AtomSoftTech/NeuWatch/presolder_01.jpg

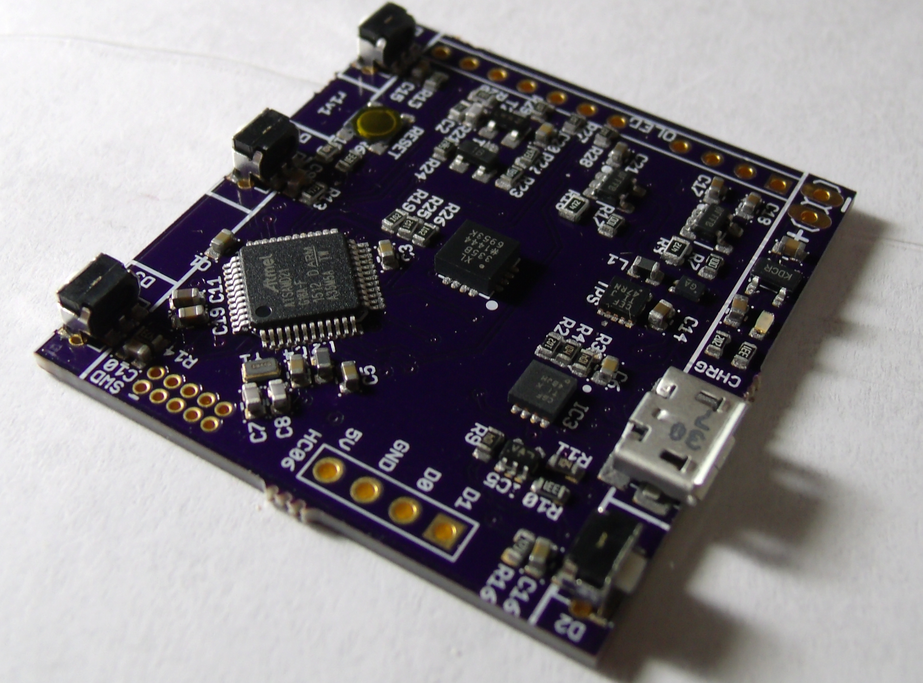
presolder_01.jpg
