AtomSoftTech/NeuWatch/soldered_02.jpg

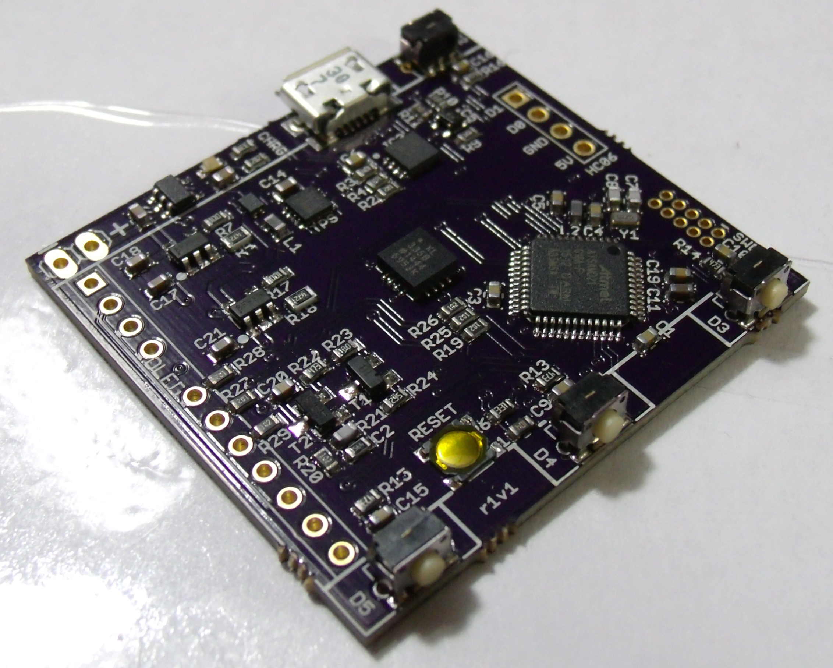
soldered_02.jpg
