AtomSoftTech/NeuWatch/readme.md

An ArduinoZero compatible watch with extra Features:<br>
<br>
ADXL335 Accelerometer<br>
MCP73831 - Lipo Charger<br>
Custom battery sense circuit<br>
Oled and MicroSD stack on PCB <br>
HC06 Bluetooth<br>
Cool side buttons<br>
<br>
Will be programable via Arduino IDE as the Zero (native)
