AtomSoftTech/NeuWatch/NeuWatch.jpg

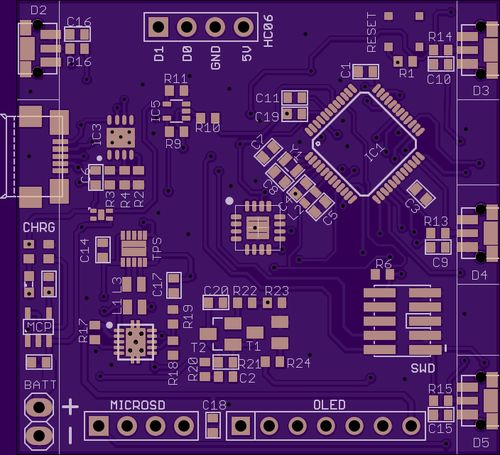
NeuWatch.jpg
