AtomSoftTech/NeuWatch/placement_chart.jpg

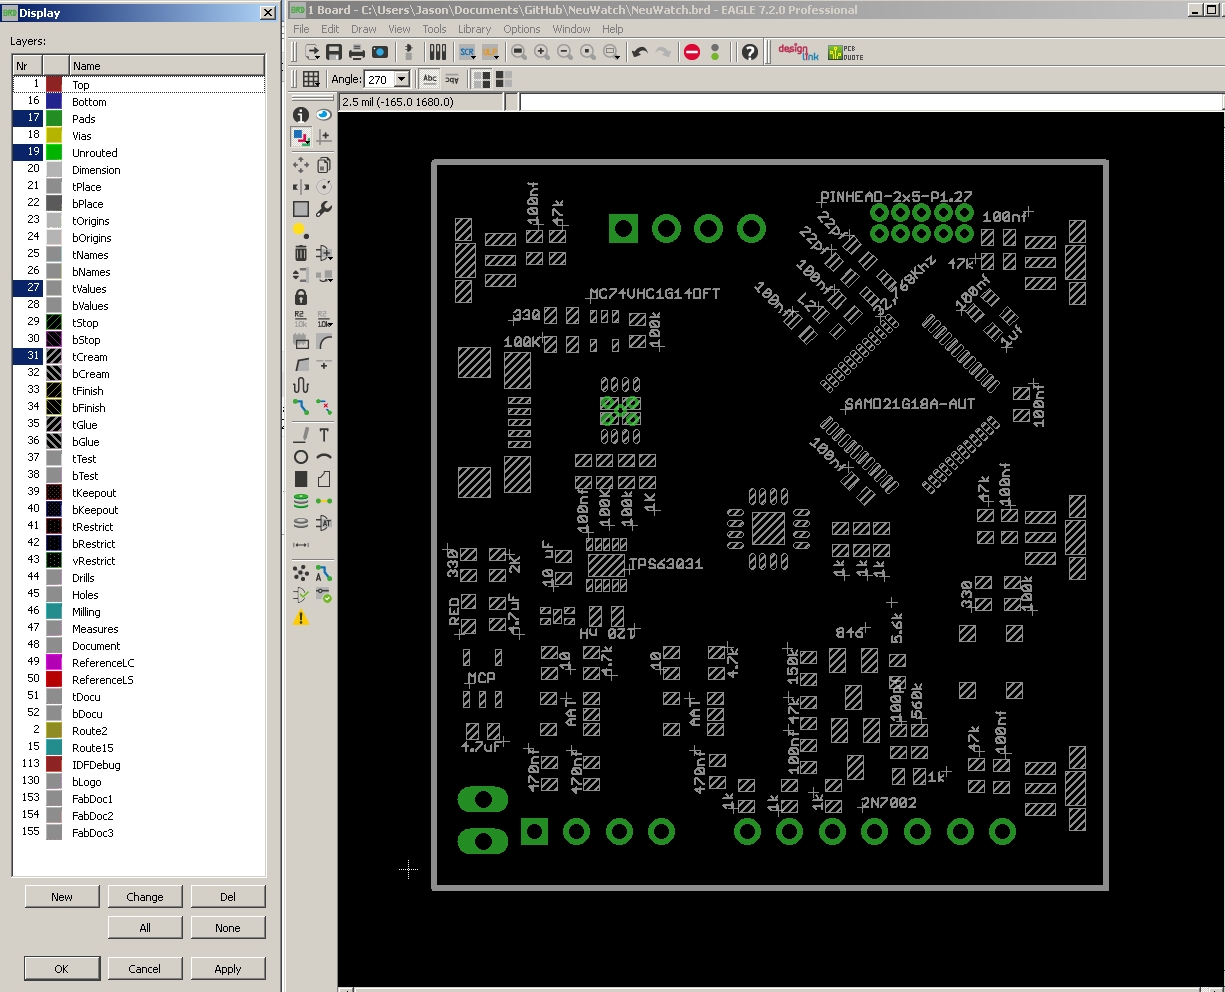
placement_chart.jpg
