AtomSoftTech/NeuWatch/NeuWatch.brd

## EAGLE design NeuWatch.brd (2015-08-29)

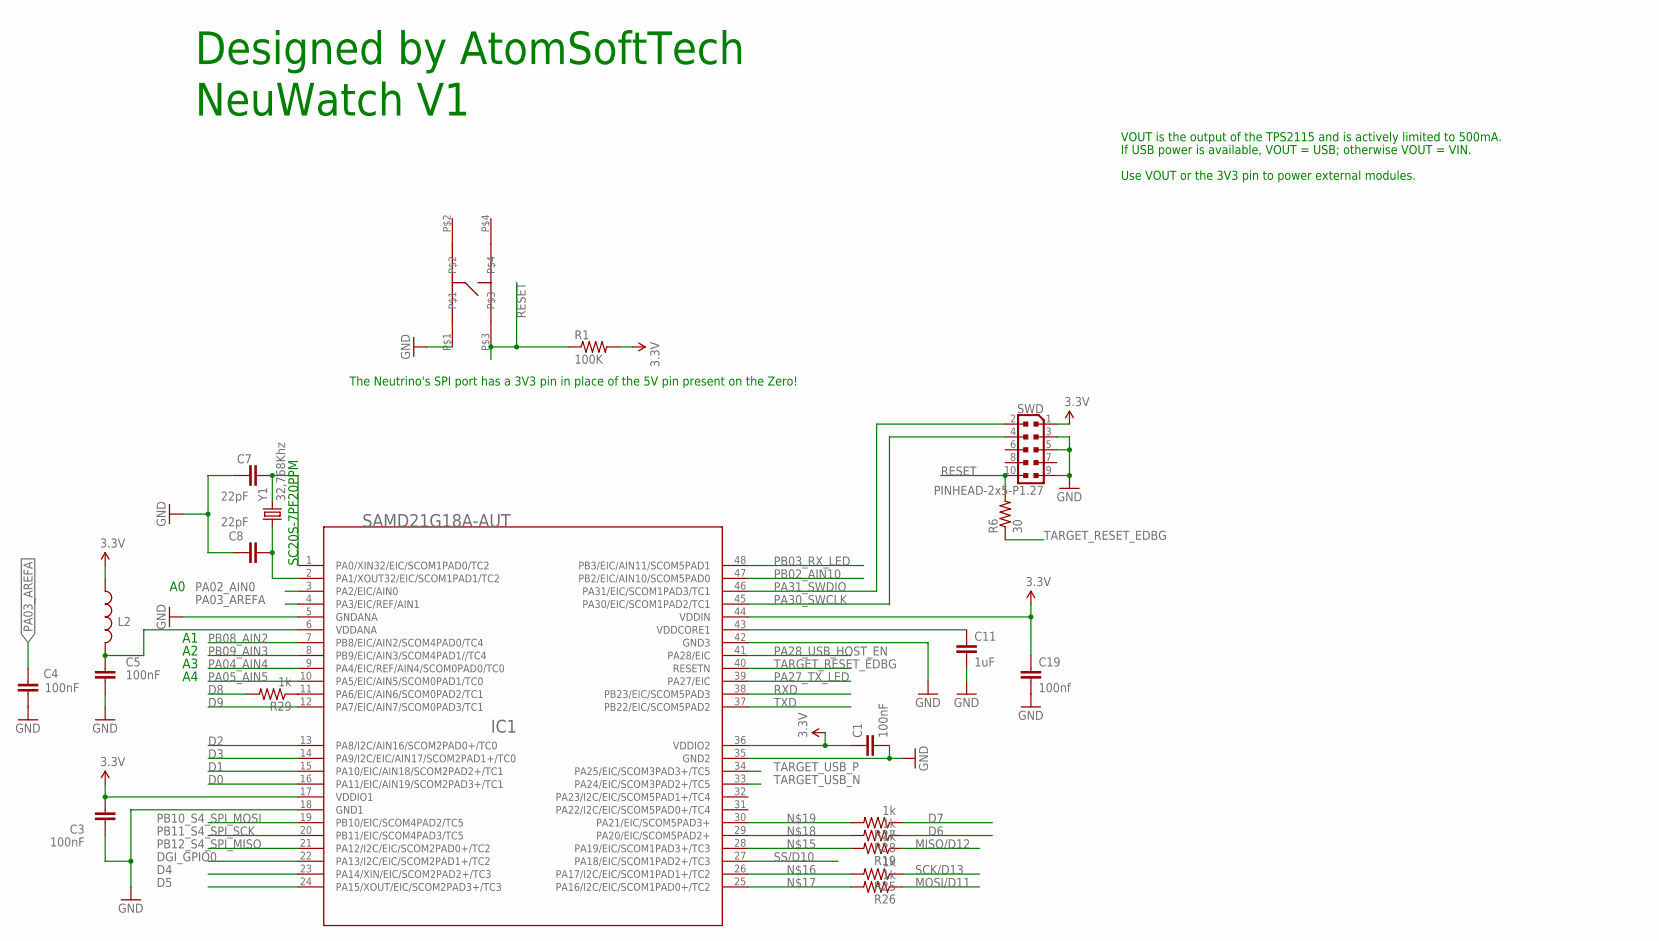
[picture p5: schematic NeuWatch.sch, sheet 1]

Parts:
C1, C3, C4, C5: 100nF; C0402
C7, C8: 22pF; C0402
C11: 1uF; C0402
C19: 100nf; C0402
IC1: SAMD21G18A-AUT; INTEGRATEDCIRCUITS_TQFP48-7X7
L2: INDUCTOR0603-TDK; 0603-TDK
R1: 100K; R0402
R6: 30; R0402
R19, R25, R26, R27, R28, R29: 1k; R0402
RESET: TACTILE_SWITCH; PTS540
SWD: PINHEAD-2x5-P1.27; ARDUINO-NEUTRINO-082_CONNETTORI_PINHEAD-2X5-P127
Y1: 32,768Khz; CRYSTAL-SMD-2.0X1.2

Connections:
3.3V: C1.1, C3.2, C19.1, IC1.17 (VDDIO1), IC1.36 (VDDIO2), IC1.44 (VDDIN), L2.1, R1.2, SWD.1; also elsewhere on the board
D0: IC1.16 (PA11/EIC/AIN19/SCOM2PAD3+/TC1); also elsewhere on the board
D1: IC1.15 (PA10/EIC/AIN18/SCOM2PAD2+/TC1); also elsewhere on the board
D2: IC1.13 (PA8/I2C/AIN16/SCOM2PAD0+/TC0); also elsewhere on the board
D3: IC1.14 (PA9/I2C/EIC/AIN17/SCOM2PAD1+/TC0); also elsewhere on the board
D4: IC1.23 (PA14/XIN/EIC/SCOM2PAD2+/TC3); also elsewhere on the board
D5: IC1.24 (PA15/XOUT/EIC/SCOM2PAD3+/TC3); also elsewhere on the board
D6: R28.1; also elsewhere on the board
D7: R27.1; also elsewhere on the board
D8: R29.2; also elsewhere on the board
D9: IC1.12 (PA7/EIC/AIN7/SCOM0PAD3/TC1); also elsewhere on the board
DGI_GPIO0: IC1.22 (PA13/I2C/EIC/SCOM2PAD1+/TC2)
GND: C1.2, C3.1, C4.2, C5.2, C7.1, C8.1, C11.2, C19.2, IC1.5 (GNDANA), IC1.18 (GND1), IC1.35 (GND2), IC1.42 (GND3), RESET.P$1, SWD.3, SWD.5, SWD.9; also elsewhere on the board
MISO/D12: R19.1; also elsewhere on the board
MOSI/D11: R26.1; also elsewhere on the board
unnamed: IC1.28 (PA19/EIC/SCOM1PAD3+/TC3), R19.2
unnamed: IC1.26 (PA17/I2C/EIC/SCOM1PAD1+/TC2), R25.2
unnamed: IC1.25 (PA16/I2C/EIC/SCOM1PAD0+/TC2), R26.2
unnamed: IC1.29 (PA20/EIC/SCOM5PAD2+), R28.2
unnamed: IC1.30 (PA21/EIC/SCOM5PAD3+), R27.2
unnamed: IC1.11 (PA6/EIC/AIN6/SCOM0PAD2/TC1), R29.1
PA00_XIN32: C7.2, IC1.1 (PA0/XIN32/EIC/SCOM1PAD0/TC2), Y1.2
PA01_XOUT32: C8.2, IC1.2 (PA1/XOUT32/EIC/SCOM1PAD1/TC2), Y1.1
PA02_AIN0: IC1.3 (PA2/EIC/AIN0); also elsewhere on the board
PA03_AREFA: C4.1, IC1.4 (PA3/EIC/REF/AIN1)
PA04_AIN4: IC1.9 (PA4/EIC/REF/AIN4/SCOM0PAD0/TC0); also elsewhere on the board
PA05_AIN5: IC1.10 (PA5/EIC/AIN5/SCOM0PAD1/TC0); also elsewhere on the board
PA27_TX_LED: IC1.39 (PA27/EIC)
PA28_USB_HOST_EN: IC1.41 (PA28/EIC); also elsewhere on the board
PA30_SWCLK: IC1.45 (PA30/EIC/SCOM1PAD2/TC1), SWD.4
PA31_SWDIO: IC1.46 (PA31/EIC/SCOM1PAD3/TC1), SWD.2
PB02_AIN10: IC1.47 (PB2/EIC/AIN10/SCOM5PAD0); also elsewhere on the board
PB03_RX_LED: IC1.48 (PB3/EIC/AIN11/SCOM5PAD1)
PB08_AIN2: IC1.7 (PB8/EIC/AIN2/SCOM4PAD0/TC4); also elsewhere on the board
PB09_AIN3: IC1.8 (PB9/EIC/AIN3/SCOM4PAD1//TC4); also elsewhere on the board
PB10_S4_SPI_MOSI: IC1.19 (PB10/EIC/SCOM4PAD2/TC5)
PB11_S4_SPI_SCK: IC1.20 (PB11/EIC/SCOM4PAD3/TC5)
PB12_S4_SPI_MISO: IC1.21 (PA12/I2C/EIC/SCOM2PAD0+/TC2)
RESET: R1.1, R6.2, RESET.P$3, SWD.10
RXD: IC1.38 (PB23/EIC/SCOM5PAD3)
SCK/D13: R25.1; also elsewhere on the board
SS/D10: IC1.27 (PA18/EIC/SCOM1PAD2+/TC3); also elsewhere on the board
TARGET_RESET_EDBG: IC1.40 (RESETN), R6.1
TARGET_USB_N: IC1.33 (PA24/EIC/SCOM3PAD2+/TC5); also elsewhere on the board
TARGET_USB_P: IC1.34 (PA25/EIC/SCOM3PAD3+/TC5); also elsewhere on the board
TXD: IC1.37 (PB22/EIC/SCOM5PAD2)
VDDANA: C5.1, IC1.6 (VDDANA), L2.2
VDDCORE: C11.1, IC1.43 (VDDCORE1)

Notes on the sheet:
The Neutrino's SPI port has a 3V3 pin in place of the 5V pin present on the Zero!
VOUT is the output of the TPS2115 and is actively limited to 500mA.
If USB power is available, VOUT = USB; otherwise VOUT = VIN.
Use VOUT or the 3V3 pin to power external modules.
Designed by AtomSoftTech
NeuWatch V1
SC20S-7PF20PPM

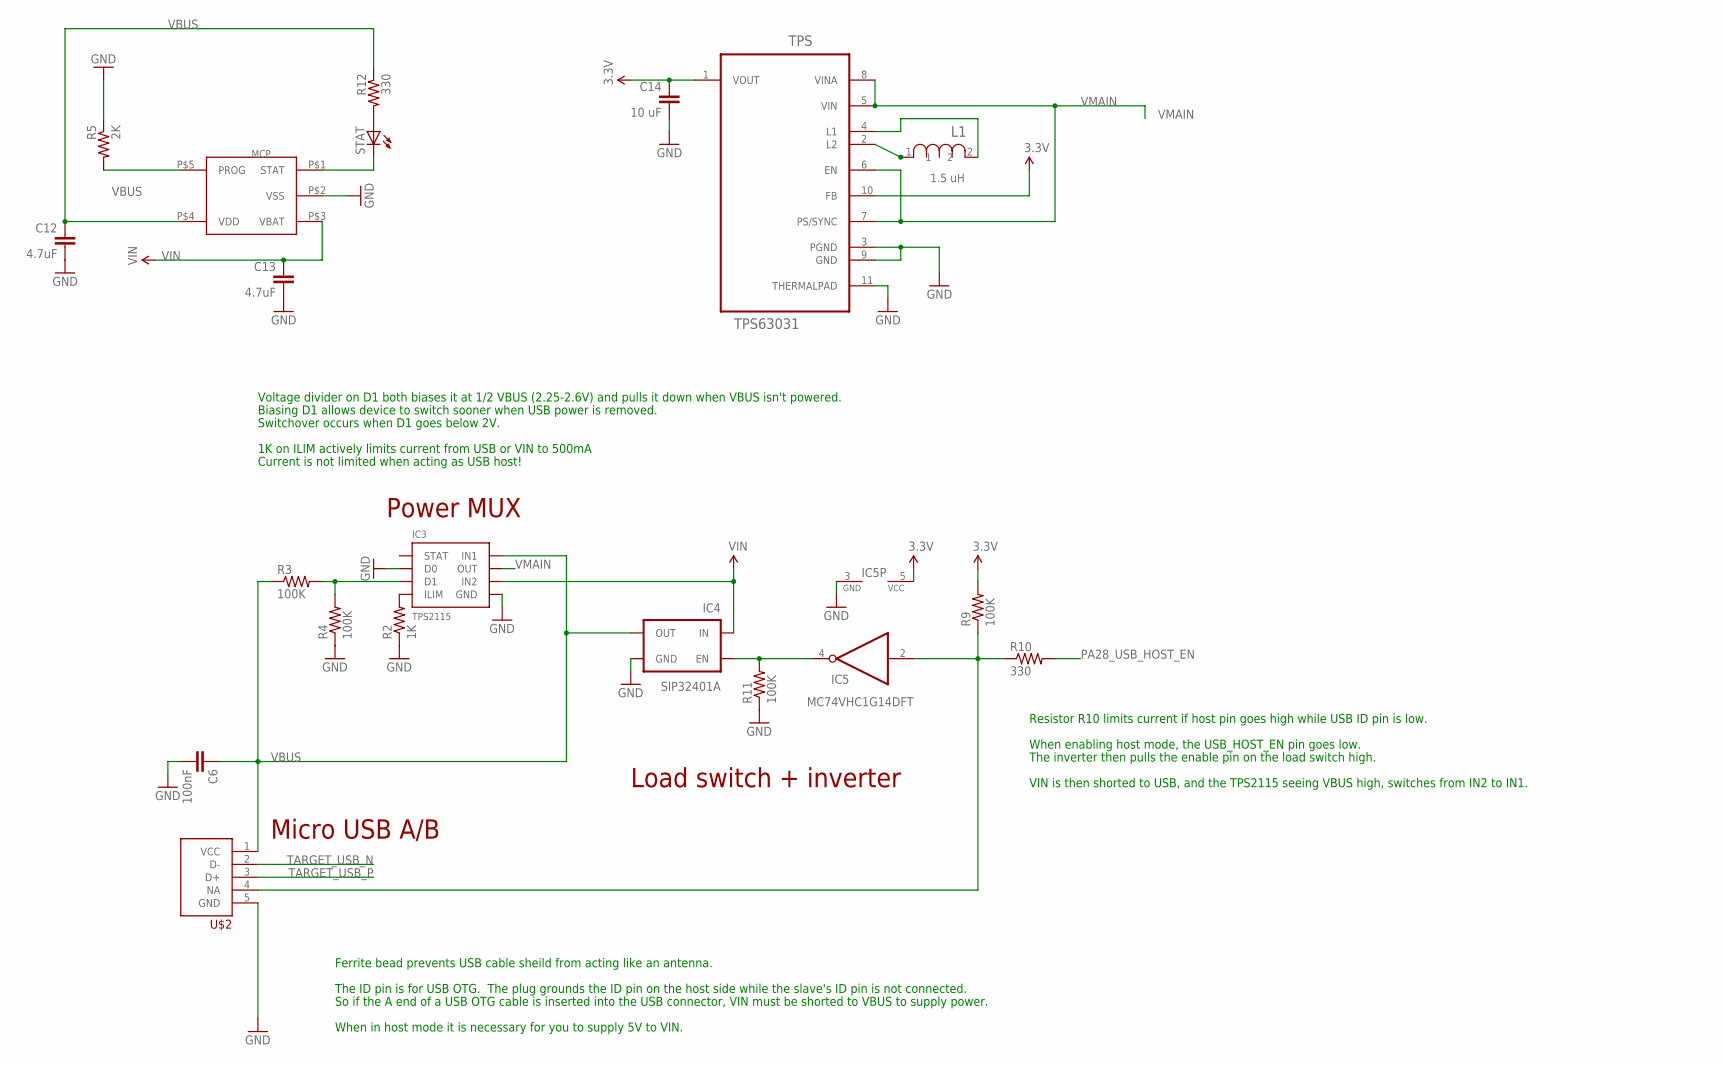
[picture p6: schematic NeuWatch.sch, sheet 2]

Parts:
C6: 100nF; C0402
C12, C13: 4.7uF; C0402
C14: 10 uF; C0402
IC3: TPS2115; 8-VDFN
IC4: SIP32401A; TDFN4
IC5: MC74VHC1G14DFT; SC70-5
L1: 1.5 uH; INDC1610X12N
MCP: MCP73831; 5PIN_SOT23
R2: 1K; R0402
R3, R4, R9, R11: 100K; R0402
R5: 2K; R0402
R10, R12: 330; R0402
STAT: LEDSML0603; SML0603
TPS: TPS63031; SON50P260X260X80-11N; MPN TPS63031
U$2: USB_GENERIC_CHEAT; 1LFS

Connections:
3.3V: C14.1, IC5.5 (VCC), R9.2, TPS.1 (VOUT), TPS.10 (FB); also elsewhere on the board
DATT1: IC3.3 (D1), R3.2, R4.2
GND: C6.2, C12.2, C13.2, C14.2, IC3.2 (D0), IC3.5 (GND), IC3.P0 (GND), IC3.V0 (GND), IC3.V1 (GND), IC3.V2 (GND), IC3.V3 (GND), IC3.V4 (GND), IC4.0 (GND), IC4.2 (GND), IC5.3 (GND), MCP.P$2 (VSS), R2.1, R4.1, R5.1, R11.1, TPS.3 (PGND), TPS.9 (GND), TPS.11 (THERMALPAD), U$2.5 (GND); also elsewhere on the board
IC4_EN: IC4.4 (EN), IC5.4 (O), R11.2
ILIM: IC3.4 (ILIM), R2.2
unnamed: L1.1, TPS.2 (L2)
unnamed: MCP.P$1 (STAT), STAT.C
unnamed: MCP.P$5 (PROG), R5.2
unnamed: R12.2, STAT.A
unnamed: L1.2, TPS.4 (L1)
unnamed: IC5.2 (I), R9.1, R10.1, U$2.4 (NA)
PA28_USB_HOST_EN: R10.2; also elsewhere on the board
TARGET_USB_N: U$2.2 (D-); also elsewhere on the board
TARGET_USB_P: U$2.3 (D+); also elsewhere on the board
VBUS: C6.1, C12.1, IC3.8 (IN1), IC4.1 (OUT), MCP.P$4 (VDD), R3.1, R12.1, U$2.1 (VCC)
VIN: C13.1, IC3.6 (IN2), IC4.3 (IN), MCP.P$3 (VBAT); also elsewhere on the board
VMAIN: IC3.7 (OUT), TPS.5 (VIN), TPS.6 (EN), TPS.7 (PS/SYNC), TPS.8 (VINA)

Notes on the sheet:
Micro USB A/B
Ferrite bead prevents USB cable sheild from acting like an antenna.
The ID pin is for USB OTG. The plug grounds the ID pin on the host side while the slave's ID pin is not connected.
So if the A end of a USB OTG cable is inserted into the USB connector, VIN must be shorted to VBUS to supply power.
When in host mode it is necessary for you to supply 5V to VIN.
1K on ILIM actively limits current from USB or VIN to 500mA
Voltage divider on D1 both biases it at 1/2 VBUS (2.25-2.6V) and pulls it down when VBUS isn't powered.
Current is not limited when acting as USB host!
Biasing D1 allows device to switch sooner when USB power is removed.
Switchover occurs when D1 goes below 2V.
When enabling host mode, the USB_HOST_EN pin goes low.
Resistor R10 limits current if host pin goes high while USB ID pin is low.
Load switch + inverter
The inverter then pulls the enable pin on the load switch high.
Power MUX
VIN is then shorted to USB, and the TPS2115 seeing VBUS high, switches from IN2 to IN1.

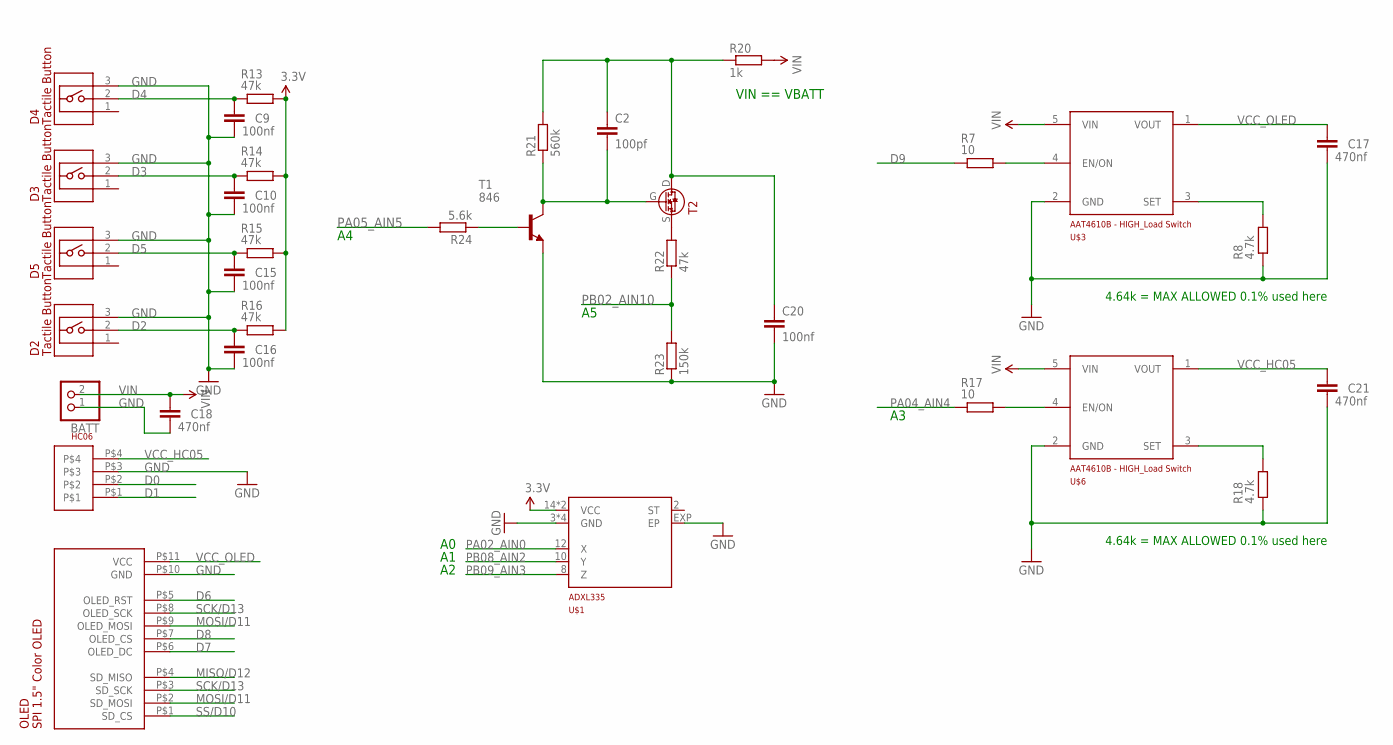
[picture p7: schematic NeuWatch.sch, sheet 3]

Parts:
BATT: PINHD-1X2; 1X02
C2: 100pf; C0402
C9, C10, C15, C16, C20: 100nf; C0402
C17, C18, C21: 470nf; C0402
D2, D3, D4, D5: BUTTON_P0; P021301
HC06: 1X4; 1B4
OLED: 1.5-OLED; 1.5OLED
R7, R17: 10; R0402
R8, R18: 4.7k; R0402
R13, R14, R15, R16, R22: 47k; R0402
R20: 1k; R0402
R21: 560k; R0402
R23: 150k; R0402
R24: 5.6k; R0402
T1: 846; SOT23-BEC
T2: 2N7002; MOSFET
U$1: ADXL335; 16LFCSP
U$3, U$6: AAT4610B; SOT23-5

Connections:
3.3V: R13.2, R14.2, R15.2, R16.2, U$1.14 (VCC), U$1.15 (VCC); also elsewhere on the board
D0: HC06.P$2; also elsewhere on the board
D1: HC06.P$1; also elsewhere on the board
D2: C16.1, D2.2, R16.1; also elsewhere on the board
D3: C10.1, D3.2, R14.1; also elsewhere on the board
D4: C9.1, D4.2, R13.1; also elsewhere on the board
D5: C15.1, D5.2, R15.1; also elsewhere on the board
D6: OLED.P$5 (OLED_RST); also elsewhere on the board
D7: OLED.P$6 (OLED_DC); also elsewhere on the board
D8: OLED.P$7 (OLED_CS); also elsewhere on the board
D9: R7.1; also elsewhere on the board
GND: BATT.1, C9.2, C10.2, C15.2, C16.2, C17.2, C18.2, C20.2, C21.2, D2.3, D3.3, D4.3, D5.3, HC06.P$3, OLED.P$10 (GND), R8.1, R18.1, R23.1, T1.E, U$1.3 (GND), U$1.5 (GND), U$1.6 (GND), U$1.7 (GND), U$1.EXP (EP), U$3.2 (GND), U$6.2 (GND); also elsewhere on the board
MISO/D12: OLED.P$4 (SD_MISO); also elsewhere on the board
MOSI/D11: OLED.P$2 (SD_MOSI), OLED.P$9 (OLED_MOSI); also elsewhere on the board
unnamed: C2.2, R21.1, T1.C, T2.G
unnamed: R24.1, T1.B
unnamed: C2.1, C20.1, R20.1, R21.2, T2.D
unnamed: R7.2, U$3.4 (EN/ON)
unnamed: R8.2, U$3.3 (SET)
unnamed: R17.2, U$6.4 (EN/ON)
unnamed: R18.2, U$6.3 (SET)
unnamed: R22.2, T2.S
PA02_AIN0: U$1.12 (X); also elsewhere on the board
PA04_AIN4: R17.1; also elsewhere on the board
PA05_AIN5: R24.2; also elsewhere on the board
PB02_AIN10: R22.1, R23.2; also elsewhere on the board
PB08_AIN2: U$1.10 (Y); also elsewhere on the board
PB09_AIN3: U$1.8 (Z); also elsewhere on the board
SCK/D13: OLED.P$3 (SD_SCK), OLED.P$8 (OLED_SCK); also elsewhere on the board
SS/D10: OLED.P$1 (SD_CS); also elsewhere on the board
VCC_HC05: C21.1, HC06.P$4, U$6.1 (VOUT)
VCC_OLED: C17.1, OLED.P$11 (VCC), U$3.1 (VOUT)
VIN: BATT.2, C18.1, R20.2, U$3.5 (VIN), U$6.5 (VIN); also elsewhere on the board

Notes on the sheet:
VIN == VBATT
4.64k = MAX ALLOWED 0.1% used here

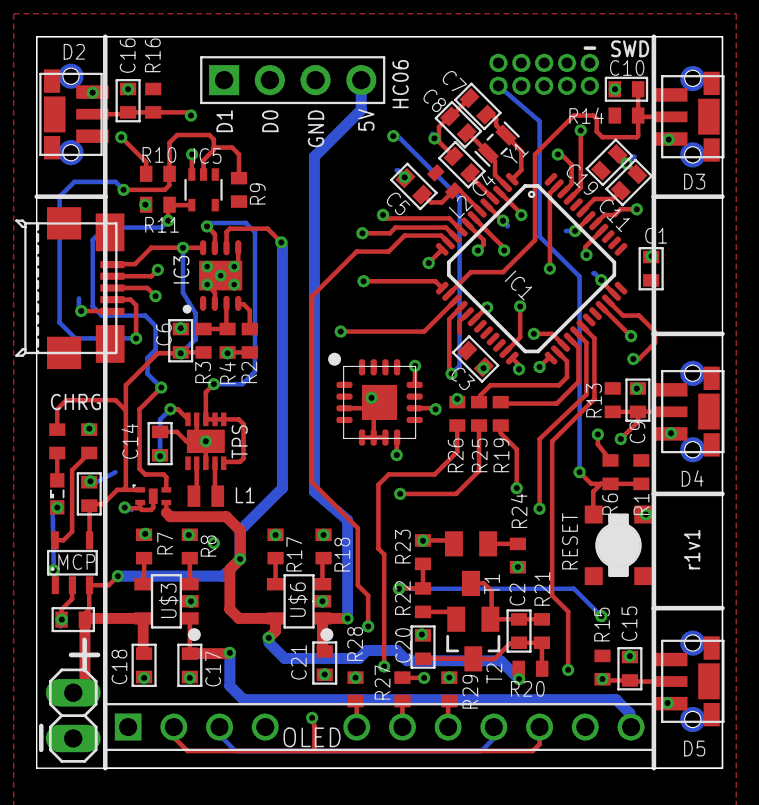
[picture p8: board NeuWatch.brd from above]

Board: 4 copper layers, 38.1 x 40.6 mm, 75 parts (0 on the bottom side), 62 nets.
