AtomSoftTech/NeuWatch/presolder_02.jpg

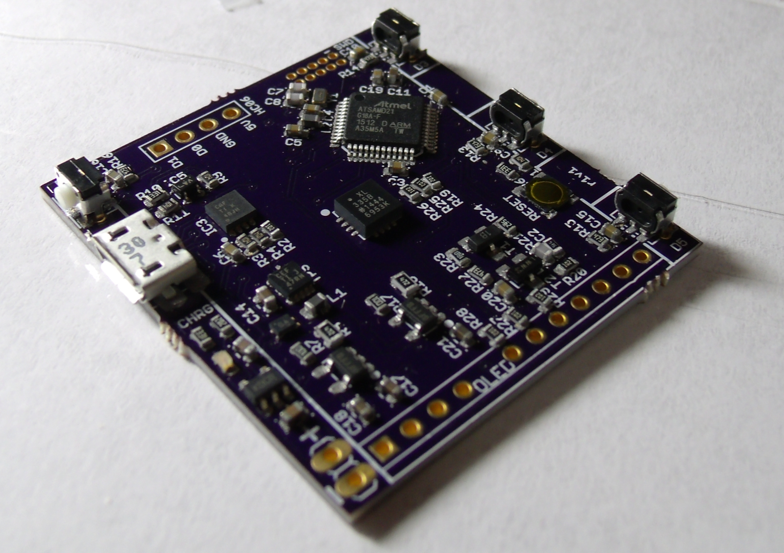
presolder_02.jpg
