AtomSoftTech/NeuWatch/soldered_01.jpg

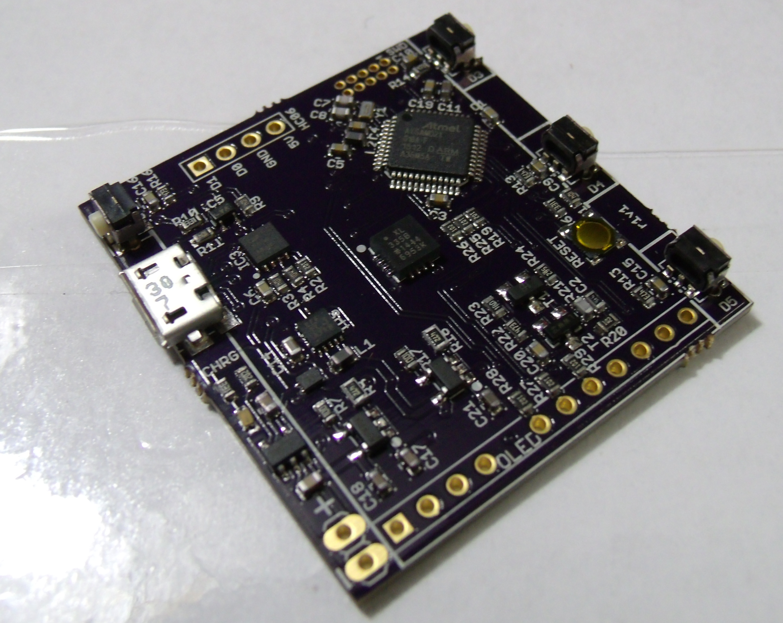
soldered_01.jpg
