AtomSoftTech/NeuWatch/(commit log)

2015-07-23 first
    fixed TPS buck
    [NeuWatch.brd, NeuWatch.sch]
2015-07-25 added batsense
    [NeuWatch.brd, NeuWatch.sch]
2015-07-25 Fixes
    I2C removed and resistors for buttons changed.
    [NeuWatch.brd, NeuWatch.sch]
2015-07-26 small fixes
    [NeuWatch.sch]
2015-07-26 via fix
    [NeuWatch.brd]
2015-07-26 batt silk
    [NeuWatch.brd]
2015-07-30 removed boost and others
    [NeuWatch.brd, NeuWatch.sch]
2015-07-30 pinout fixed
    [NeuWatch.brd, NeuWatch.sch]
2015-07-30 high side load
    for OLED and UART cutoff
    [NeuWatch.brd, NeuWatch.sch]
2015-08-01 vin control
    [NeuWatch.brd, NeuWatch.sch]
2015-08-03 CLR SPI
    Current Limiting Resistors added to SPI
    [NeuWatch.brd, NeuWatch.sch]
2015-08-05 added CLR again
    [NeuWatch.brd, NeuWatch.sch]
2015-08-08 power traces thicker
    [NeuWatch.brd]
2015-08-29 R6 fix
    [NeuWatch.brd, NeuWatch.sch]
